riosnav/sen69c-esp32-tft-air-monitor/enclosure/main_enclosure.step

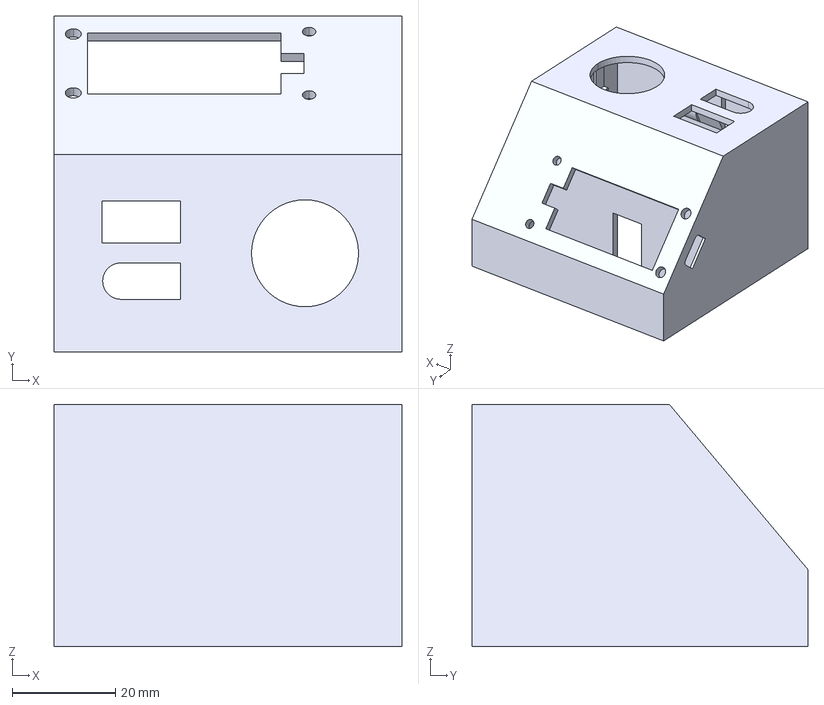
[picture p5: CAD file, 2026-11-09]
enclosure/main_enclosure.step
67.5 x 65.1 x 47.0 mm
