riosnav/sen69c-esp32-tft-air-monitor/enclosure/lid.step

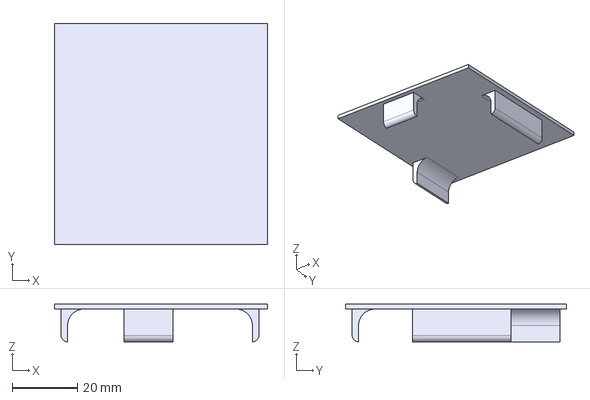
[picture p6: CAD file, 2026-11-09]
enclosure/lid.step
65.1 x 67.5 x 11.5 mm
