riosnav/sen69c-esp32-tft-air-monitor/src/Settings.cpp

// SPDX-License-Identifier: GPL-3.0-or-later

/// @file
/// @brief Loading and saving the settings and the battery's state with
/// Preferences, in the NVS namespace `settings` (see Settings.h).

#include "Settings.h"

#include <Preferences.h>

#include <algorithm>
#include <cmath>
#include <iterator>

#include "Device.h"

namespace settings {

namespace {
constexpr const char* kNamespace = "settings";  ///< The NVS namespace for all of it.
constexpr size_t kWebPasswordLength = 8;  ///< The random web password's length.
/// @brief Puts back the default of any setting outside the range the menu and
/// the web page allow, e.g. one saved by a firmware version with more choices.
/// @param[in,out] s The settings.
void keepInRange(Settings& s) {
  const Settings defaults;
  if (s.brightness < 10 || s.brightness > 100) s.brightness = defaults.brightness;
  if (std::find(std::begin(kDimOptionsS), std::end(kDimOptionsS), s.dimAfterS) ==
      std::end(kDimOptionsS)) {
    s.dimAfterS = defaults.dimAfterS;
  }
  if (static_cast<uint8_t>(s.led) > static_cast<uint8_t>(LedMode::Bright)) s.led = defaults.led;
  if (static_cast<uint8_t>(s.silence) > static_cast<uint8_t>(Silence::All)) {
    s.silence = defaults.silence;
  }
  if (!(std::fabs(s.tempOffsetC) <= 10)) s.tempOffsetC = defaults.tempOffsetC;  // NaN too
  if (s.altitudeM > 3000) s.altitudeM = defaults.altitudeM;
  if (s.mqttPort == 0) s.mqttPort = defaults.mqttPort;
}

}  // namespace

Settings load() {
  Settings s;
  Preferences p;
  bool hasPassword = false;
  if (p.begin(kNamespace, true)) {
    s.brightness = p.getUChar("bright", s.brightness);
    s.dimAfterS = p.getUShort("dim", s.dimAfterS);
    s.screenOffWhenIdle = p.getBool("idleOff", s.screenOffWhenIdle);
    s.fahrenheit = p.getBool("degF", s.fahrenheit);
    s.led = static_cast<LedMode>(p.getUChar("led", static_cast<uint8_t>(s.led)));
    s.silence = static_cast<Silence>(p.getUChar("silence", static_cast<uint8_t>(s.silence)));
    s.tempOffsetC = p.getFloat("tOffset", s.tempOffsetC);
    s.altitudeM = p.getUShort("alt", s.altitudeM);
    s.co2SelfCalibration = p.getBool("co2Asc", s.co2SelfCalibration);
    s.wifiEnabled = p.getBool("wifi", s.wifiEnabled);
    if (p.isKey("name")) p.getString("name", s.name, sizeof s.name);
    hasPassword = p.isKey("webPass");
    if (hasPassword) p.getString("webPass", s.webPassword, sizeof s.webPassword);
    s.mqttEnabled = p.getBool("mqtt", s.mqttEnabled);
    if (p.isKey("mqttHost")) p.getString("mqttHost", s.mqttHost, sizeof s.mqttHost);
    s.mqttPort = p.getUShort("mqttPort", s.mqttPort);
    if (p.isKey("mqttUser")) p.getString("mqttUser", s.mqttUser, sizeof s.mqttUser);
    if (p.isKey("mqttPass")) p.getString("mqttPass", s.mqttPassword, sizeof s.mqttPassword);
    p.end();
  }
  keepInRange(s);
  if (!hasPassword) {
    // First start, or after a factory reset.
    device::randomPassword(s.webPassword, kWebPasswordLength);
    save(s);
  }
  return s;
}

void save(const Settings& s) {
  Preferences p;
  if (!p.begin(kNamespace, false)) {
    Serial.println("Settings: could not save them");
    return;
  }
  p.putUChar("bright", s.brightness);
  p.putUShort("dim", s.dimAfterS);
  p.putBool("idleOff", s.screenOffWhenIdle);
  p.putBool("degF", s.fahrenheit);
  p.putUChar("led", static_cast<uint8_t>(s.led));
  p.putUChar("silence", static_cast<uint8_t>(s.silence));
  p.putFloat("tOffset", s.tempOffsetC);
  p.putUShort("alt", s.altitudeM);
  p.putBool("co2Asc", s.co2SelfCalibration);
  p.putBool("wifi", s.wifiEnabled);
  p.putString("name", s.name);
  p.putString("webPass", s.webPassword);
  p.putBool("mqtt", s.mqttEnabled);
  p.putString("mqttHost", s.mqttHost);
  p.putUShort("mqttPort", s.mqttPort);
  p.putString("mqttUser", s.mqttUser);
  p.putString("mqttPass", s.mqttPassword);
  p.end();
}

void erase() {
  Preferences p;
  if (!p.begin(kNamespace, false)) return;
  p.clear();
  p.end();
}

// Under the key of the setting it replaces ("A battery is connected"), so a
// monitor that had it ticked starts with a battery.
bool loadBatteryPresent() {
  Preferences p;
  if (!p.begin(kNamespace, true)) return false;
  const bool present = p.getBool("battery", false);
  p.end();
  return present;
}

void saveBatteryPresent(bool present) {
  Preferences p;
  if (!p.begin(kNamespace, false)) return;
  p.putBool("battery", present);
  p.end();
}

float loadBatteryEmpty() {
  Preferences p;
  if (!p.begin(kNamespace, true)) return NAN;
  const float percent = p.getFloat("battEmpty", NAN);
  p.end();
  return percent;
}

void saveBatteryEmpty(float percent) {
  Preferences p;
  if (!p.begin(kNamespace, false)) return;
  p.putFloat("battEmpty", percent);
  p.end();
}

}  // namespace settings
