riosnav/sen69c-esp32-tft-air-monitor/src/net/Ota.cpp

// SPDX-License-Identifier: GPL-3.0-or-later

/// @file
/// @brief Firmware updates over Wi-Fi: receiving the image, confirming it on
/// the monitor, and confirming or rolling back new firmware (see Ota.h).

#include "Ota.h"

#include <Arduino.h>
#include <esp_app_format.h>

#include <cstring>

#include "System.h"

namespace {

/// How long a new image has to rejoin Wi-Fi before it's rolled back, in ms.
constexpr uint32_t kProbationMs = 5 * 60000;
/// After a yes, time for the web page to hear it before the restart, in ms.
constexpr uint32_t kRestartDelayMs = 3000;

/// @brief Where the app description starts in an app image, in bytes.
///
/// An app image starts with the image header, the first segment's header and
/// the app description.
constexpr size_t kAppDescOffset = sizeof(esp_image_header_t) + sizeof(esp_image_segment_header_t);

}  // namespace

/// @brief Tells the Arduino core not to confirm a new image at boot;
/// Ota::loop() does.
/// @return Always true.
extern "C" bool verifyRollbackLater() { return true; }

void Ota::begin() {
  esp_ota_img_states_t state;
  probation_ = esp_ota_get_state_partition(esp_ota_get_running_partition(), &state) == ESP_OK &&
               state == ESP_OTA_IMG_PENDING_VERIFY;
  if (probation_) Serial.println("OTA: new firmware, confirms itself once it rejoins Wi-Fi");
}

void Ota::loop(bool connected, bool offline, uint32_t nowMs) {
  OtaState confirming = OtaState::Confirming;
  if (static_cast<int32_t>(nowMs - deadlineMs_) >= 0 &&
      state_.compare_exchange_strong(confirming, OtaState::TimedOut)) {
    Serial.println("OTA: not confirmed on the monitor; update discarded");
  }

  if (!probation_) return;
  if (connected || offline) {
    probation_ = false;
    esp_ota_mark_app_valid_cancel_rollback();
    Serial.println("OTA: new firmware confirmed");
  } else if (nowMs >= kProbationMs) {
    Serial.println("OTA: new firmware can't rejoin Wi-Fi; rolling back");
    Serial.flush();
    esp_ota_mark_app_invalid_rollback_and_reboot();
  }
}

const char* Ota::start(size_t size) {
  OtaState current = state_;
  do {
    if (current == OtaState::Receiving || current == OtaState::Confirming ||
        current == OtaState::Accepted) {
      return "Another update is running";
    }
  } while (!state_.compare_exchange_weak(current, OtaState::Receiving));
  written_ = 0;
  size_ = size;
  partition_ = esp_ota_get_next_update_partition(nullptr);
  if (partition_ == nullptr) return fail("No OTA partition");
  if (size < kAppDescOffset + sizeof(esp_app_desc_t) || size > partition_->size) {
    return fail("Wrong file size for a firmware image");
  }
  if (esp_ota_begin(partition_, OTA_WITH_SEQUENTIAL_WRITES, &handle_) != ESP_OK) {
    return fail("Could not start the update");
  }
  Serial.printf("OTA: receiving %u bytes\n", static_cast<unsigned>(size));
  return nullptr;
}

const char* Ota::write(const uint8_t* data, size_t length) {
  if (written_ == 0) {
    // Refuse anything that isn't an app image for this chip, such as the
    // merged "factory" image that also contains the bootloader.
    esp_image_header_t header;
    esp_app_desc_t desc;
    if (length < kAppDescOffset + sizeof desc) return fail("Not a firmware image");
    memcpy(&header, data, sizeof header);
    memcpy(&desc, data + kAppDescOffset, sizeof desc);
    if (header.magic != ESP_IMAGE_HEADER_MAGIC || desc.magic_word != ESP_APP_DESC_MAGIC_WORD) {
      return fail("Not a firmware image (use firmware.bin)");
    }
    if (header.chip_id != CONFIG_IDF_FIRMWARE_CHIP_ID) return fail("Firmware is for another chip");
  }
  if (esp_ota_write(handle_, data, length) != ESP_OK) return fail("Could not write to flash");
  written_ += length;
  return nullptr;
}

const char* Ota::finish() {
  if (written_ != size_) return fail("Upload incomplete");
  const esp_err_t err = esp_ota_end(handle_);
  handle_ = 0;
  if (err != ESP_OK) return fail("The image is damaged");
  Serial.println("OTA: update stored; waiting for confirmation on the monitor");
  deadlineMs_ = millis() + kConfirmWindowMs;
  state_ = OtaState::Confirming;
  return nullptr;
}

void Ota::abort() { fail(nullptr); }

void Ota::confirm() {
  OtaState confirming = OtaState::Confirming;
  if (!state_.compare_exchange_strong(confirming, OtaState::Accepted)) return;
  if (esp_ota_set_boot_partition(partition_) != ESP_OK) {
    Serial.println("OTA: could not select the image");
    state_ = OtaState::Failed;
    return;
  }
  Serial.println("OTA: confirmed on the monitor; restarting into it");
  sys::restartLater(kRestartDelayMs);
}

void Ota::refuse() {
  OtaState confirming = OtaState::Confirming;
  if (state_.compare_exchange_strong(confirming, OtaState::Refused)) {
    Serial.println("OTA: refused on the monitor; update discarded");
  }
}

const char* Ota::fail(const char* reason) {
  if (handle_ != 0) esp_ota_abort(handle_);
  handle_ = 0;
  if (reason != nullptr) Serial.printf("OTA: %s\n", reason);
  state_ = OtaState::Idle;
  return reason;
}

uint8_t Ota::percent() const {
  const uint32_t size = size_;  // set by the web server's task
  return size == 0 ? 0 : static_cast<uint8_t>(static_cast<uint64_t>(written_.load()) * 100 / size);
}

uint32_t Ota::secondsLeft(uint32_t nowMs) const {
  if (state_ != OtaState::Confirming) return 0;
  const int32_t left = static_cast<int32_t>(deadlineMs_ - nowMs);
  return left > 0 ? (static_cast<uint32_t>(left) + 999) / 1000 : 0;
}
