riosnav/sen69c-esp32-tft-air-monitor/src/ui/Ui.cpp

// SPDX-License-Identifier: GPL-3.0-or-later

/// @file
/// @brief The UI's input and state: buttons, the menu and its actions,
/// alerts, the backlight and the status LED (see Ui.h; the drawing is in
/// UiDraw.cpp).

#include "Ui.h"

#include <algorithm>
#include <iterator>

#include "Power.h"

namespace {

/// @brief The buttons' pins: D0, D1 and D2.
///
/// D0 doubles as BOOT and is pulled up; D1/D2 are pulled down (so they can wake
/// the chip from deep sleep), so they read HIGH when pressed.
constexpr uint8_t kButtonPins[] = {0, 1, 2};
constexpr bool kPressedLevel[] = {LOW, HIGH, HIGH};  ///< What each button reads while pressed.

constexpr uint8_t kDimmedBrightness = 4;  ///< Backlight while dimmed, of 255.
constexpr uint32_t kDrawIntervalMs = 250;  ///< How often to redraw, in ms, even if nothing changed.
constexpr uint32_t kToastMs = 4000;  ///< How long a toast shows, in ms.
constexpr uint32_t kMenuTimeoutMs = 60000;  ///< A menu left alone this long closes, in ms.
/// An alert left alone this long on screen closes, as if dismissed, in ms.
constexpr uint32_t kAlertTimeoutMs = 60000;
/// When the screen switches off while silenced, in s, if it's set never to dim.
constexpr uint32_t kSilencedIdleS = 120;
/// CO2 in fresh outdoor air, in ppm: the forced recalibration's reference.
constexpr uint16_t kOutdoorCo2Ppm = 420;

/// @brief Steps an enum through its values, wrapping around.
/// @tparam E The enum, with values from 0 to `count` - 1.
/// @param value The value to step from.
/// @param delta How far: +1 for the next value, -1 for the previous one.
/// @param count The enum's `Count`, one past its last value.
/// @return The value stepped to.
template <typename E>
E stepEnum(E value, int delta, E count) {
  const int n = static_cast<int>(count);
  return static_cast<E>((static_cast<int>(value) + delta + n) % n);
}

/// @brief A brightness setting as the backlight takes it.
/// @param percent The brightness, in %.
/// @return The backlight, of 255.
uint8_t backlight(uint8_t percent) { return static_cast<uint8_t>(percent * 255 / 100); }

/// @brief Whether an alert at `level` may turn the screen on.
///
/// A very low battery counts as an alarm, since the monitor will soon switch
/// itself off; a low one as a warning.
/// @param silence The Silence setting.
/// @param level The alert's level.
bool wakesScreen(Silence silence, aq::Level level) {
  return silence == Silence::Off || (silence == Silence::Warnings && level == aq::Level::Alarm);
}

/// @brief Whether an update fills the screen: it's arriving, waiting for an
/// answer, or installing.
/// @param state The update's state.
bool updating(OtaState state) {
  return state == OtaState::Receiving || state == OtaState::Confirming ||
         state == OtaState::Accepted;
}

}  // namespace

void Ui::begin(SensorService& sensor, Settings& settings, const aq::AirQuality& airQuality,
               const aq::MetricHistory& history, WifiService& wifi, Ota& ota,
               const MqttService& mqtt, const power::BatteryWatch& battery) {
  sensor_ = &sensor;
  settings_ = &settings;
  aq_ = &airQuality;
  history_ = &history;
  wifi_ = &wifi;
  ota_ = &ota;
  mqtt_ = &mqtt;
  battery_ = &battery;

  for (size_t i = 0; i < 3; ++i) {
    pinMode(kButtonPins[i], kPressedLevel[i] == LOW ? INPUT_PULLUP : INPUT_PULLDOWN);
    // E.g. D1 still held from switching on: not a long press for the menu.
    if (digitalRead(kButtonPins[i]) == kPressedLevel[i]) buttons_[i].ignoreHeld();
  }
  tft_.init();
  tft_.setRotation(1);  // landscape, buttons on the left (D0 top, D2 bottom)
  tft_.setBrightness(backlight(settings.brightness));
  frame_.setColorDepth(16);
  if (!frame_.createSprite(tft_.width(), tft_.height())) Serial.println("UI: no memory for frame");
  lastInputMs_ = millis();
}

void Ui::update(const SensorSnapshot& snapshot, uint32_t nowMs) {
  snapshot_ = snapshot;
  if (settingsChanged_) {
    settingsChanged_ = false;
    applyBacklight();
    commitSettings();
    dirty_ = true;
  }
  if (snapshot.resultSequence != resultSequence_) {
    resultSequence_ = snapshot.resultSequence;
    showToast(snapshot.result, nowMs);
  }
  if (toast_[0] != '\0' && static_cast<int32_t>(nowMs - toastUntilMs_) >= 0) {
    toast_[0] = '\0';  // its time is up
    dirty_ = true;
  }
  updateAlerts(nowMs);
  updatePrompt(nowMs);
  for (size_t i = 0; i < 3; ++i) {
    const bool down = digitalRead(kButtonPins[i]) == kPressedLevel[i];
    handleButton(i, buttons_[i].update(down, nowMs), nowMs);
  }
  // Left alone, menus close by themselves, saving a value being changed.
  if (mode_ != Mode::Pages && nowMs - lastInputMs_ >= kMenuTimeoutMs) {
    if (mode_ == Mode::Edit) commitSettings();
    mode_ = Mode::Pages;
    dirty_ = true;
  }
  updateBacklight(nowMs);
  // Silenced, the LED stays dark, except for an alarm that may turn the screen on.
  const bool alarm = alertVisible_ && alertLevel_ == aq::Level::Alarm;
  const bool ledOn =
      settings_->silence == Silence::Off || (alarm && wakesScreen(settings_->silence, alertLevel_));
  led_.update(aq_->overall(), warmingUp(), alarm, ledOn ? settings_->led : LedMode::Off, nowMs);
  if (dirty_ || nowMs - lastDrawMs_ >= kDrawIntervalMs) {
    draw(nowMs);
    lastDrawMs_ = nowMs;
    dirty_ = false;
  }
}

void Ui::showBatteryEmpty() {
  batteryEmpty_ = true;
  dimmed_ = false;
  applyBacklight();
  draw(millis());
}

void Ui::showPoweringOff(uint32_t secondsLeft) {
  offInS_ = secondsLeft;
  draw(millis());
}

void Ui::handleButton(size_t button, aq::ButtonEvent event, uint32_t nowMs) {
  using aq::ButtonEvent;
  if (event == ButtonEvent::None) return;
  lastInputMs_ = nowMs;
  if (ota_->state() == OtaState::Confirming) {
    onUpdatePromptEvent(button, event, nowMs);
    return;
  }
  if (event == ButtonEvent::Press) {
    // A press that wakes the screen does nothing else.
    if (dimmed_) {
      buttons_[button].swallow();
      updateBacklight(nowMs);
    }
    return;
  }
  dirty_ = true;
  if (updating(ota_->state())) return;  // nothing to do but wait
  if (wifi_->setupActive()) {
    // D1 cancels the setup, or closes it once it has worked.
    if (button == 1 && event == ButtonEvent::Click) wifi_->stopSetup();
    return;
  }
  if (alertShowing()) {
    if (event == ButtonEvent::Click) dismissAlert();
    return;
  }
  switch (mode_) {
    case Mode::Pages:
      onPageEvent(button, event);
      break;
    case Mode::Menu:
      onMenuEvent(button, event);
      break;
    case Mode::Edit:
      onEditEvent(button, event);
      break;
    case Mode::Confirm:
      onConfirmEvent(button, event);
      break;
    case Mode::Link:
      if (event == ButtonEvent::Click) mode_ = Mode::Pages;
      break;
  }
}

void Ui::onPageEvent(size_t button, aq::ButtonEvent event) {
  using aq::ButtonEvent;
  if (button == 1 && event == ButtonEvent::LongPress) {
    mode_ = Mode::Menu;
    item_ = Item::Brightness;
    menuTop_ = 0;
    return;
  }
  if (event != ButtonEvent::Click) return;
  if (button == 0) {
    page_ = stepEnum(page_, -1, Page::Count);
  } else if (button == 2) {
    page_ = stepEnum(page_, +1, Page::Count);
  } else if (page_ == Page::TrendHour || page_ == Page::TrendDay || page_ == Page::TrendWeek) {
    trendMetric_ = (trendMetric_ + 1) % kTrendMetrics.size();
  } else if (page_ == Page::Network) {
    onNetworkAction();
  } else if (page_ == Page::Device && snapshot_.deviceStatus != 0) {
    sensor_->clearErrors();
  }
}

void Ui::onNetworkAction() {
  if (!settings_->wifiEnabled && wifi_->saved().size() > 0) {
    settings_->wifiEnabled = true;
    commitSettings();
  } else if (wifi_->state() == WifiState::Connected) {
    mode_ = Mode::Link;  // QR code of the web page
  } else {
    wifi_->startSetup();
  }
}

void Ui::onMenuEvent(size_t button, aq::ButtonEvent event) {
  using aq::ButtonEvent;
  if (button == 1) {
    if (event == ButtonEvent::Click) {
      select(item_);
    } else if (event == ButtonEvent::LongPress) {
      mode_ = Mode::Pages;
    }
    return;
  }
  // Clicks move one row; holding keeps scrolling.
  item_ = stepEnum(item_, button == 0 ? -1 : +1, Item::Count);
}

void Ui::onEditEvent(size_t button, aq::ButtonEvent event) {
  using aq::ButtonEvent;
  if (button == 1) {
    if (event == ButtonEvent::Click) {
      mode_ = Mode::Menu;
      commitSettings();
    }
    return;
  }
  editRepeats_ = event == ButtonEvent::Click ? 0 : editRepeats_ + 1;
  adjust(item_, button == 0 ? +1 : -1);
}

void Ui::onConfirmEvent(size_t button, aq::ButtonEvent event) {
  using aq::ButtonEvent;
  if (button == 1 && event == ButtonEvent::LongPress) {
    mode_ = Mode::Pages;
    execute(confirmItem_);
  } else if (button != 1 && event == ButtonEvent::Click) {
    mode_ = Mode::Menu;
  }
}

void Ui::onUpdatePromptEvent(size_t button, aq::ButtonEvent event, uint32_t nowMs) {
  if (event == aq::ButtonEvent::Press && !holding_) {
    holding_ = true;
    holdButton_ = button;
    holdStartMs_ = nowMs;
  } else if (event == aq::ButtonEvent::Click) {
    ota_->refuse();
  }
  dirty_ = true;
}

void Ui::updatePrompt(uint32_t nowMs) {
  const OtaState state = ota_->state();
  if (state != otaState_) {
    otaState_ = state;
    holding_ = false;
    dirty_ = true;
    switch (state) {
      case OtaState::Confirming:
        lastInputMs_ = nowMs;  // wake the screen
        break;
      case OtaState::Refused:
        showToast("Update refused", nowMs);
        break;
      case OtaState::TimedOut:
        showToast("Update not confirmed", nowMs);
        break;
      case OtaState::Failed:
        showToast("Update could not be installed", nowMs);
        break;
      default:
        break;
    }
  }
  if (state != OtaState::Confirming || !holding_) return;
  if (!buttons_[holdButton_].pressed()) {
    ota_->refuse();  // let go too soon
  } else if (nowMs - holdStartMs_ >= Ota::kConfirmHoldMs) {
    ota_->confirm();
  }
}

void Ui::select(Item item) {
  switch (item) {
    case Item::Brightness:
    case Item::TempOffset:
    case Item::Altitude:
      mode_ = Mode::Edit;
      editRepeats_ = 0;
      break;
    case Item::DimAfter:
    case Item::IdleScreen:
    case Item::Units:
    case Item::Led:
    case Item::Silence:
    case Item::Wifi:
    case Item::Co2SelfCalibration:
      adjust(item, +1);
      commitSettings();
      break;
    case Item::WifiSetup:
      mode_ = Mode::Pages;
      page_ = Page::Network;  // where the result shows once the setup ends
      wifi_->startSetup();
      break;
    case Item::CleanFan:
    case Item::HeatHumiditySensor:
    case Item::RestartVoc:
    case Item::CalibrateCo2:
    case Item::ResetCo2:
    case Item::ForgetWifi:
    case Item::Restart:
    case Item::PowerOff:
    case Item::FactoryReset:
      confirmItem_ = item;
      mode_ = Mode::Confirm;
      break;
    case Item::Close:
    case Item::Count:
      mode_ = Mode::Pages;
      break;
  }
}

void Ui::adjust(Item item, int direction) {
  Settings& s = *settings_;
  switch (item) {
    case Item::Brightness:
      s.brightness = static_cast<uint8_t>(std::clamp(s.brightness + direction * 10, 10, 100));
      tft_.setBrightness(backlight(s.brightness));
      break;
    case Item::DimAfter: {
      const size_t n = std::size(kDimOptionsS);
      size_t i = 0;
      while (i < n && kDimOptionsS[i] != s.dimAfterS) ++i;
      s.dimAfterS = kDimOptionsS[(i + n + direction) % n];
      break;
    }
    case Item::IdleScreen:
      s.screenOffWhenIdle = !s.screenOffWhenIdle;
      break;
    case Item::Units:
      s.fahrenheit = !s.fahrenheit;
      break;
    case Item::Led:
      s.led = static_cast<LedMode>((static_cast<int>(s.led) + direction + 3) % 3);
      break;
    case Item::Silence:
      s.silence = static_cast<Silence>((static_cast<int>(s.silence) + direction + 3) % 3);
      break;
    case Item::Wifi:
      s.wifiEnabled = !s.wifiEnabled;
      break;
    case Item::TempOffset:
      s.tempOffsetC = std::clamp(std::round(s.tempOffsetC * 10 + direction) / 10, -10.0f, 10.0f);
      break;
    case Item::Altitude: {
      // Holding the button speeds up after a second or two.
      const int step = editRepeats_ > 10 ? 100 : 10;
      s.altitudeM = static_cast<uint16_t>(
          std::clamp((s.altitudeM + direction * step) / step * step, 0, 3000));
      break;
    }
    case Item::Co2SelfCalibration:
      s.co2SelfCalibration = !s.co2SelfCalibration;
      break;
    default:
      break;
  }
}

void Ui::execute(Item item) {
  switch (item) {
    case Item::CleanFan:
      sensor_->cleanFan();
      break;
    case Item::HeatHumiditySensor:
      sensor_->heatHumiditySensor();
      break;
    case Item::RestartVoc:
      sensor_->restartVocLearning();
      break;
    case Item::CalibrateCo2:
      sensor_->recalibrateCo2(kOutdoorCo2Ppm);
      break;
    case Item::ResetCo2:
      sensor_->resetCo2Calibration();
      break;
    case Item::ForgetWifi:
      wifi_->forgetAll();
      showToast("Wi-Fi networks forgotten", millis());
      break;
    case Item::Restart:
      ESP.restart();
      break;
    case Item::PowerOff:
      poweringOff_ = true;  // the main loop counts down and switches off
      offInS_ = power::kOffCountdownS;
      break;
    case Item::FactoryReset:
      settings::erase();
      wifi_->forgetAll();
      ESP.restart();
      break;
    default:
      break;
  }
}

void Ui::commitSettings() {
  settings::save(*settings_);
  sensor_->applyConfig(
      {settings_->tempOffsetC, settings_->altitudeM, settings_->co2SelfCalibration});
}

void Ui::updateAlerts(uint32_t nowMs) {
  // Show the worst metric that is at warning or alarm and hasn't been
  // acknowledged at that level. Once a metric improves its acknowledgement is
  // lowered too, so it alerts again if it gets worse. A value that's briefly
  // unknown, e.g. while the sensor restarts, hasn't improved.
  bool found = false;
  aq::Metric metric = aq::Metric::Co2;
  aq::Level level = aq::Level::Good;
  for (aq::Metric m : aq::kPriority) {
    aq::Level& acknowledged = acknowledged_[aq::idx(m)];
    const aq::Level current = aq_->level(m);
    if (current != aq::Level::Unknown && current < acknowledged) acknowledged = current;
    if (aq_->thresholds(m).any() && current >= aq::Level::Warning && current > acknowledged &&
        current > level) {
      found = true;
      metric = m;
      level = current;
    }
  }
  bool isNew = found && (!alertVisible_ || metric != alertMetric_ || level != alertLevel_);
  alertVisible_ = found;
  alertMetric_ = metric;
  alertLevel_ = level;

  // The battery, while it runs the monitor: low, then very low. It waits
  // behind an air alert.
  const uint8_t battery = battery_->warning();
  if (battery < batteryAcknowledged_) batteryAcknowledged_ = battery;
  const uint8_t batteryAlert = battery > batteryAcknowledged_ ? battery : 0;
  if (batteryAlert != batteryAlert_ && batteryAlert != 0 && !alertVisible_) isNew = true;
  batteryAlert_ = batteryAlert;

  if (isNew) {
    alertShownMs_ = nowMs;
    // Silenced, it waits for a button press to turn the screen on.
    const aq::Level shown = alertVisible_         ? alertLevel_
                            : batteryAlert_ == 2 ? aq::Level::Alarm
                                                 : aq::Level::Warning;
    if (wakesScreen(settings_->silence, shown)) lastInputMs_ = nowMs;  // wake the screen
    dirty_ = true;
  }
  // Left alone, an alert closes by itself, as if dismissed, a minute after
  // it could be seen: the screen on, and not filled by something else.
  if (alertShowing() && (dimmed_ || fullScreen())) alertShownMs_ = nowMs;
  if (alertShowing() && nowMs - alertShownMs_ >= kAlertTimeoutMs) dismissAlert();
}

void Ui::dismissAlert() {
  if (alertVisible_) {
    acknowledged_[aq::idx(alertMetric_)] = alertLevel_;
    alertVisible_ = false;
  } else {
    batteryAcknowledged_ = batteryAlert_;
    batteryAlert_ = 0;
  }
  alertShownMs_ = millis();  // the timeout starts again for an alert waiting behind
  dirty_ = true;
}

void Ui::updateBacklight(uint32_t nowMs) {
  // Screens that show something to scan or wait for stay bright, and so does
  // an alert once the screen is on.
  const bool alertOnScreen = alertShowing() && !dimmed_;
  const uint32_t idleS = idleAfterS();
  const bool dim = idleS != 0 && mode_ == Mode::Pages && !fullScreen() && !alertOnScreen &&
                   nowMs - lastInputMs_ >= idleS * 1000UL;
  // Idle, the time since the last input stops growing, so millis() wrapping
  // after 49.7 days doesn't make it look recent.
  if (dim) lastInputMs_ = nowMs - idleS * 1000UL;
  if (dim == dimmed_) return;
  dimmed_ = dim;
  applyBacklight();
}

bool Ui::fullScreen() const { return wifi_->setupActive() || updating(ota_->state()); }

uint32_t Ui::idleAfterS() const {
  const bool never = settings_->dimAfterS == 0;
  return never && settings_->silence != Silence::Off ? kSilencedIdleS : settings_->dimAfterS;
}

void Ui::applyBacklight() {
  const bool off = dimmed_ && (settings_->screenOffWhenIdle || settings_->silence != Silence::Off);
  if (off != screenOff_) {
    screenOff_ = off;
    if (off) {
      tft_.sleep();
    } else {
      tft_.wakeup();
    }
  }
  if (!off) tft_.setBrightness(dimmed_ ? kDimmedBrightness : backlight(settings_->brightness));
}

void Ui::showToast(const char* text, uint32_t nowMs) {
  strlcpy(toast_, text, sizeof toast_);
  toastUntilMs_ = nowMs + kToastMs;
  dirty_ = true;
}

bool Ui::warmingUp() const {
  if (snapshot_.state != SensorState::Measuring) return true;
  for (float v : snapshot_.measurement.values) {
    if (std::isnan(v)) return true;
  }
  return false;
}
