riosnav/sen69c-esp32-tft-air-monitor/tools/screen-renderer/shim/DNSServer.h

// SPDX-License-Identifier: GPL-3.0-or-later

/// @file
/// @brief Stand-in for Arduino-ESP32's DNSServer.h (a WifiService member).
#pragma once

/// Stand-in for Arduino-ESP32's DNS server: empty, as only WifiService's
/// declaration needs it.
class DNSServer {};
