riosnav/sen69c-esp32-tft-air-monitor/(commit log)

2026-10-29 M0: hardware bring-up
    - pioarduino build pinned to Arduino-ESP32 3.3.11 (ESP-IDF 5.5.5),
    two 1.875 MB OTA partitions, build output kept out of the repo
    - LovyanGFX config for the 240x135 ST7789 panel (rotation and offset
    verified on hardware)
    - I2C scan, SEN69C readout over USB serial and on screen, button and
    NeoPixel checks
    - GPL-3.0-or-later license, README, third-party notices
2026-10-29 M1: standalone air-quality monitor
    - Sensor task owns the I2C bus: resumes or starts measuring, re-applies
    volatile sensor settings, blanks PM for the first 30 s, polls status and
    battery, and runs fan cleaning and forced CO2 recalibration on request.
    - aqcore library: warning/alarm levels with hysteresis, 1 h and 24 h
    history, button debouncing with long press and repeat, comfort maths,
    with Unity tests that run on the board.
    - UI with seven pages (overview, particles, gases, comfort, two trend
    charts, device), a settings menu, pop-up alerts with acknowledgement,
    auto-dim and a NeoPixel status LED.
    - Settings stored in NVS.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
2026-10-30 Web chart clock times and readout, value info, battery option
    - Web chart: clock times on the time axis; hovering or touching shows
    the time and value under the pointer.
    - (i) on every value: what it is, the health risk, its limits and their
    sources (CO2 now cites Health Canada, the German UBA and UK BB101).
    - "Jump here when a value is clicked" switch, remembered per browser.
    - Battery readings are only shown when a battery is set as connected;
    without one the gauge reads the charger (off by default).
    - The sensor reports its altitude back when it's set, and the web page
    shows it. Kept in RTC memory, so it stays valid across restarts that
    leave the sensor measuring.
    - Menus close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
2026-10-30 Show the sensor's tolerance on the web page
    Values and the chart readout show the typical tolerance from Sensirion's
    SEN6x datasheet (SEN69C), and the chart shades it as a band around the
    line. The info box gives the formula and when it applies. A checkbox
    turns it off, remembered by the browser. The VOC and NOx indices have no
    band, as every sensor reads 100 and 1 in a room's usual air.
2026-10-30 Fixes from the M2 hardware tests
    - Wi-Fi page: when a saved network is in range but can't be joined, say
    so and why ("Couldn't join WIFI / Wrong password?") instead of "No saved
    network in range".
    - Count WIFI_REASON_AUTH_EXPIRE as a wrong password: the router sends it
    when it rejects the key during setup, which was reported as "No answer"
    after the 20 s timeout.
    - After a restart, keep the sensor measuring only if it has our altitude
    and CO2 self-calibration setting. After a factory reset it kept the old
    altitude while the settings said 0 m; now it's reconfigured.
    [SensorService.cpp, UiDraw.cpp, WifiService.cpp, WifiService.h]
2026-10-30 Group the settings menu: display, Wi-Fi, sensor, device
    Forget Wi-Fi now follows Wi-Fi and Set up Wi-Fi, and the CO2 calibration
    follows CO2 self-calibration.
2026-10-30 M3: Home Assistant over MQTT (v0.3.0)
    The monitor publishes to an MQTT broker, such as Home Assistant's Mosquitto
    add-on, using ESP-IDF's MQTT client:
    - MQTT device discovery announces one device with a sensor per value, a
    Good/Fair/Poor status sensor per value with limits, the overall air
    quality and the Wi-Fi signal. Units are spelled as Home Assistant
    expects (Greek mu), so it keeps long-term statistics.
    - Readings every 30 s as JSON on <host>/state; <host>/status is
    online/offline, with a last will so Home Assistant shows the sensors
    as unavailable when the monitor loses power.
    - Broker, port, user and password on the web page (POST /api/mqtt),
    saved with the other settings.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
    [Json.h, MqttService.cpp, MqttService.h, Settings.cpp, Settings.h, Ui.cpp, Ui.h, UiDraw.cpp]
2026-10-30 Close alert pop-ups by themselves after a minute
    Left alone, an alert now counts as dismissed after 60 s, as the menus
    close by themselves, instead of waiting for a button. The value only
    alerts again if it gets worse.
2026-10-30 README: rewrite for builders new to the project
    Reorganised in the order a newcomer needs it: what you need (with product
    numbers, what's included, cables, power, optional battery), assembly,
    installing the firmware step by step (getting the code, VS Code and the
    pioarduino extension, the first 3-4 GB download, what success looks
    like), first start, using it (levels, accuracy, settings), Wi-Fi and
    the web page, Home Assistant, updating, troubleshooting, and a separate
    section for developers.
    Also corrects: the board ships with Adafruit's demo (not CircuitPython),
    Home Assistant 2026.2 calls add-ons apps, the setup hotspot's timeouts,
    the size of the tools and build output, and that pio isn'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
2026-10-30 Screen: messages over the title bar, no space before one-digit numbers
    - Messages such as "Fan cleaned" cover the title bar instead of the
    bottom strip. There they cut through the last row on the overview,
    particles and gases pages, with the tops of the digits showing above
    the bar; the title bar is in the same place on every screen.
    - Whole numbers with one digit are drawn without a leading space:
    Arduino's String(value, 0) pads to two characters, so NOx showed as
    " 1". Also fixes the trend graphs' limits and the battery percentage.
    - Removes a duplicate comment.
    Found with a desktop renderer of the screen.
    [UiDraw.cpp]
2026-10-30 Sensor: VOC and NOx of 0 count as not measured yet
    The indices run from 1 to 500, but for about the first minute of a
    measurement (after power-up, fan cleaning, or a settings change that
    restarts the sensor) the SEN69C reports 0 rather than unknown. That
    showed as "VOC 0" and "NOx 0", rated good, and went to Home Assistant
    and the trend graphs as real readings. They now show "--" until the
    sensor has values.
2026-10-30 README: screenshots of the screen, the web page and Home Assistant
    One each: the main screen (from a desktop renderer of the firmware's UI
    code), the top of the web page (served with made-up readings and generic
    names), and the monitor's device page in Home Assistant.
2026-10-30 README: no-warranty disclaimer
    A plain-language disclaimer (as is, at your own risk, no liability, not a
    safety or certified measuring device), and the GPL's standard no-warranty
    paragraph in the License section.
2026-10-30 Name the project sen69c-esp32-tft-air-monitor
    The repository's name on GitHub, in the README's download and update
    steps, and as the origin of the Home Assistant discovery message, which
    now also links to the project.
2026-10-31 Screen: say "Busy" when the sensor's activity doesn't fit
    While the sensor is busy, the title bar shows what it's doing, e.g.
    "Cleaning fan", at the right. Beside a long page title that text ran into
    the title; when it doesn't fit, it now says "Busy". The Device page still
    shows the whole text.
    [UiDraw.cpp]
2026-10-31 README and web page: the sensor doesn't clean its fan by itself
    Both said the sensor also cleans its fan weekly on its own, which the
    SEN69C doesn't do; that's what Clean fan is for.
2026-10-31 README: name the board and the sensor in the first paragraph
    The Adafruit ESP32-S3 Reverse TFT Feather and the Sensirion SEN69C, on
    Adafruit's SEN6x breakout board.
2026-10-31 Heat the humidity sensor, from the menu or the web page
    After a long time in very humid air, the SEN69C's humidity sensor reads
    too high; a second of its built-in heater fixes that. The heater may only
    run while the sensor is idle, so measuring stops, the heater runs (sensor
    firmware 9.0 and later report when it's done), and measuring starts again
    after the 20 s the datasheet asks for. Readings pause for about a minute.
    New: Settings > Heat humidity sensor, with a confirmation, and a task
    under Maintenance on the web page (action heatHumiditySensor).
    [SensorService.cpp, SensorService.h, Ui.cpp, Ui.h, UiDraw.cpp, Web.cpp, Web.h]
2026-10-31 Reset the CO2 calibration, from the menu or the web page
    Erases every CO2 calibration, forced or automatic (CO2 Sensor Factory
    Reset), e.g. to undo a calibration made indoors by mistake. The automatic
    self-calibration then starts over.
    New: Settings > Reset CO2 calibration, with a confirmation, and a task
    under Maintenance on the web page (action resetCo2Calibration).
    [SensorService.cpp, SensorService.h, Ui.cpp, Ui.h, UiDraw.cpp, Web.cpp, Web.h]
2026-10-31 Clear the sensor's errors, from the Device page or the web page
    The SEN69C keeps most error flags set until they're read and cleared,
    even once the error is gone. D1 on the Device page now clears them while
    one is shown (Read And Clear Device Status), and so does a task on the
    web page that only appears while there is an error (action clearErrors).
    An error that comes back is still there.
    The web page also names the errors (fan, CO2, ...) instead of showing
    the status in hex.
    [SensorService.cpp, SensorService.h, Ui.cpp, UiDraw.cpp, Web.cpp, Web.h]
2026-10-31 Wi-Fi: a fixed IP address per saved network
    DHCP stays the default. On the web page, the new IP address button next
    to a saved network sets an address, subnet mask, gateway and optional DNS
    server for it; other networks keep using DHCP. The values are checked in
    lib/netcore (Ipv4, with unit tests) and stored with the network only when
    set, so saved networks need no migration. Changing the address of the
    network in use rejoins it at once. The monitor's Wi-Fi page marks a fixed
    address.
    [UiDraw.cpp, Web.cpp, Web.h, WifiService.cpp, WifiService.h, WifiStore.cpp, WifiStore.h]
2026-10-31 Web page: wait after wrong passwords
    After 3 wrong passwords in a row, every password is refused for a minute,
    then twice as long after each further miss, up to 15 minutes (HTTP 429
    with Retry-After). Guessing becomes slow, but the owner is never locked
    out for long. A request without a password doesn't count as a guess.
    The Device page, on the monitor and on the web page, shows how many
    wrong passwords there have been since the monitor started. The logic is
    in lib/netcore (LoginGuard), with unit tests.
    [UiDraw.cpp, Web.cpp, Web.h]
2026-10-31 Firmware updates: install only once confirmed on the monitor
    An uploaded image is stored, then the monitor asks whether to install
    it: holding any of its buttons for 5 s installs it; a short press, or 2
    minutes without an answer, discards it. So a stolen web password alone
    isn't enough to replace the firmware.
    POST /api/ota now answers 202, and the web page follows the new GET
    /api/ota to say whether the update was accepted, refused or timed out.
    [Ota.cpp, Ota.h, Ui.cpp, Ui.h, UiDraw.cpp, Web.cpp, Web.h]
2026-10-31 Battery: charge state and low-battery warnings
    The battery gauge's charge rate (MAX17048 CRATE) tells whether the
    battery is charging or running the monitor; the gauge's hibernation is
    turned off so the rate stays current. The logic is in the new
    lib/powercore (BatteryWatch), with unit tests.
    With "A battery is connected" ticked:
    - the Device page shows the charge and whether it's charging or in use;
    - while the battery runs the monitor, a pop-up warns at 20 % and again
    at 10 %, and the web page shows a banner;
    - Home Assistant gets a Battery sensor, removed again when the setting
    is turned off.
2026-10-31 Battery: switch off cleanly before it's empty
    Below about 3.5 V the board can't give the sensor the 3.15 V it needs.
    After a minute there while discharging, the monitor says so on the
    screen, tells Home Assistant it's going offline, and goes into deep sleep
    with the backlight, the STEMMA QT port (so the sensor) and the NeoPixel
    switched off.
    It wakes every 5 minutes, and on D1 or D2, and starts again once the
    battery is charging or above 3.8 V; a button pressed before then shows
    why it doesn't start.
    [MqttService.cpp, MqttService.h, Power.cpp, Power.h, Screens.h, Ui.cpp, Ui.h, UiDraw.cpp]
2026-10-31 Settings: power off
    To carry the monitor around on its battery: the same deep sleep as for an
    empty battery, but without waking on a timer, so it draws about 0.1 mA.
    Holding D1 or D2 for 2 s turns it on again; a brief press, e.g. in a bag,
    lets it sleep on, and USB power alone doesn't start it. Before sleeping,
    the battery gauge may hibernate again and the sensor task stops using the
    bus.
    [Power.cpp, Power.h, SensorService.cpp, SensorService.h, Ui.cpp, Ui.h, UiDraw.cpp, main.cpp]
2026-10-31 Screen renderer in tools/screen-renderer, for Linux and Windows
    It draws the monitor's screens to PNG files from the firmware's own UI
    code (Ui.cpp, UiDraw.cpp, Text.cpp, aqcore and powercore) with
    LovyanGFX: to see every screen without the hardware, and to check UI
    changes. The README's screenshot comes from it. Until now it lived
    outside this repository.
    It builds with CMake on Linux (GCC, build.sh) and on Windows (MSVC,
    build.ps1), with identical images, and downloads LovyanGFX 1.2.33 itself.
    scripts/gallery.txt renders every screen, including the new ones in
    1.1.0.
2026-10-31 README: mention the battery tests
    The tests paragraph listed what aqcore and netcore test, but not
    lib/powercore: the battery warnings and when to switch off.
2026-11-01 Levels: follow Spain's indoor air standard UNE 171330:2024
    Fair is the standard's "acceptable" value for IDA 2 (offices and
    classrooms, the closest category to a home) and Poor its maximum: a
    building passes when most readings are below the first and none is
    above the second. Its values are meant for single readings, like the
    monitor's, while the WHO and EU values are mostly 24-hour averages.
    - CO2: 950 / 2500 ppm (was 1000 / 1500). The standard counts 500 ppm
    above outdoor air, taken as 450 ppm.
    - PM2.5: 15 / 50 ug/m3 (was 15 / 35).
    - Temperature: Poor below 17 C (was 16), the standard's limit.
    The other limits keep their values, with European sources where the
    standard has none: the EU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
2026-11-01 Web: say why the monitor last started
    /api/state has a new "resetReason" (power-on, restart, crash, watchdog,
    brownout, wake, usb or other), and the web page's Device section shows
    it as "Last start". Until now the reason was only printed over USB at
    start-up, so a restart seen in the uptime couldn't be told apart from
    an unplug afterwards.
    [Web.cpp]
2026-11-01 History: keep 7 days of 1-minute means
    The 1-minute history grows from 24 hours to 7 days: about 400 KB more,
    still in PSRAM, which has about 1.6 MB left. It is still kept in memory
    only, so it starts over after a restart.
    - Screen: a new trend page for the last 7 days, after the 24-hour one.
    Each pixel column averages about 50 minutes. The trend titles
    shorten "Temperature" to "Temp.", which ran into the Wi-Fi icon.
    - Web: a "7 days" button on the chart. /api/history?range=week sends
    5-minute means (2016 values), enough for a chart; the day range
    still sends the 1-minute means.
    - aq::groupMeans() averages the newest samples of a ring in groups,
    with a unit test.
    - The screen rend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
    [Simulator.cpp, Ui.cpp, Ui.h, UiDraw.cpp, Web.cpp, Web.h, World.h, main.cpp]
2026-11-01 Web: download the 7-day history as a CSV file
    A "Download all values (CSV)" button under the chart saves every value's
    1-minute means for the last 7 days, a row per minute, with the local
    time of each minute.
    The monitor has no clock, so /api/history.csv gives how many seconds ago
    each minute started, and the page turns that into times with the
    browser's clock. Temperature follows the °C/°F setting. The firmware
    copies the history into PSRAM under the lock (about 400 KB, freed
    afterwards) and sends it without holding the lock.
2026-11-01 Sensor: restart VOC learning without unplugging
    A new "Restart VOC learning" item in the menu (with a confirm screen)
    and in the web page's maintenance section, action restartVocLearning.
    The VOC and NOx indices compare the air with what they learned over
    the last hours; after moving the monitor to a room with different air,
    starting afresh helps. The datasheet's only ways to restart the VOC
    algorithm are a power cycle or a Device Reset (0xD304), which has the
    same effect. So the sensor task stops measuring, resets the sensor,
    and starts again, setting the altitude, CO2 self-calibration and
    temperature offset the sensor forgot. CO2 calibrations are kept, as
    across an unplug.
    Co-Authored-By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
    [Fakes.cpp, SensorService.cpp, SensorService.h, Simulator.cpp, Ui.cpp, Ui.h, UiDraw.cpp, Web.cpp]
2026-11-01 Display: option to switch the screen off when idle
    A new setting, "Idle screen" (menu) or "Then: dim it / switch it off"
    (web page, idleScreen in /api/settings), chooses what happens after the
    "Dim after" time. It defaults to dimming, as before.
    Switched off, the backlight goes to 0 and the display chip sleeps; the
    power pin the screen shares with the sensor's connector stays on, so
    the sensor, history, web page and Home Assistant carry on. A button
    press or an alert wakes it, like a dimmed screen.
2026-11-01 Sensor: measure at least 60 s before stopping
    The VOC and NOx algorithms only take their starting point after about
    45 s of measuring (until then they report 0, shown as "--"). Stopped
    earlier, they take it from the unsettled readings after the restart.
    Found on the device: heating the humidity sensor 30 s after "Restart
    VOC learning" left NOx near 500 and VOC at 1. The same restart alone,
    and the heater 5 minutes later, were both fine.
    Every operation that stops the sensor (fan cleaning, heater, CO2
    actions, settings changes) now waits until it has measured for 60 s,
    instead of the 24 s CO2 conditioning needs. Normally nothing changes;
    right after a start the operation just begins a little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
2026-11-01 Display: say "Receiving update" until an update is confirmed
    The screen said "Updating firmware" while an update was only being
    uploaded: it is stored beside the running firmware and installed only
    once someone holds a button on the monitor. It now says "Receiving
    update" and "Asks before installing", and "Installing update" once
    confirmed.
2026-11-01 Power: start right after the 2 s hold; count down before switching off
    Turning the monitor on waited until D1 or D2 was released after the
    2 s hold, which was confusing, and didn't help against a button held
    in a bag either: the wait gave up after 10 s. It now starts as soon as
    the hold is long enough. The UI ignores a button that is already down
    when it starts (ButtonLogic::ignoreHeld, with a unit test), so the held
    D1 doesn't open the settings, and the 2 s wait for a serial monitor is
    skipped after waking.
    Switching off showed how to turn it on again for only about 3 s. The
    screen now counts down from 10 s ("Off in 10 s") before switching off.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
    [Power.cpp, Power.h, Ui.cpp, Ui.h, UiDraw.cpp, main.cpp]
2026-11-01 Wi-Fi: answer the web page before a new address takes effect
    Saving a fixed address (or going back to the router's) for the network
    in use rejoined inside the web request, so the page never got its
    answer and just stopped working. And the first attempt to join again
    timed out: the monitor took about 35 s to count itself connected.
    - The monitor answers first and rejoins 1 s later, and waits up to 1 s
    for the old connection to go before joining (it was 100 ms). It now
    rejoins in about 1 s.
    - The page follows the monitor to its new address. Going back to the
    router's address, the new one isn't known yet: the page tries the
    address the router gave it before (now in /api/wifi as routerI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
    [Web.cpp, WifiService.cpp, WifiService.h]
2026-11-01 MQTT: try the broker again after 3 s
    The MQTT client waited its default 10 s before reconnecting after losing
    the broker, e.g. when Wi-Fi rejoined after an address change, so Home
    Assistant got the monitor back about 15 s later. With 3 s it was back
    3.4 s after Wi-Fi.
    [MqttService.cpp]
2026-11-03 Power: keep D1 and D2 pulled down while asleep
    Asleep, the chip watches the wake buttons through its RTC side, whose
    pull-down resistors are separate from the ones pinMode() sets. They
    were never switched on, so D1 and D2 floated and woke the monitor
    about 3.5 times a second: 353 times in 100 s after Power off.
    - After Power off it went back to sleep each time, unseen, but kept
    drawing current.
    - Switched off for an empty battery, it showed "Battery empty" every
    few seconds and kept draining the battery.
    Now it stays asleep until a real press: 1 wake in a minute's test.
2026-11-04 Battery: tell USB power from the voltage, not only the charge rate
    The battery monitor works out its charge rate from the charge over time,
    so it lags a minute or more behind USB power being plugged in or
    unplugged. Meanwhile the monitor said "in use" on USB power, and after
    starting again on USB power with an empty battery it raised the 20 %
    warning while plugged in.
    - A jump of 60 mV or more between readings now counts as USB power
    plugged in or unplugged, until the rate follows or 5 minutes pass.
    Wi-Fi traffic dips single readings by up to about 45 mV; a reading
    after a dip doesn't count as a rise.
    - Starting again because USB power is back counts as plugged in.
    - Above 4.1 V the b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
    [Power.cpp, Power.h, SensorService.cpp, SensorService.h, UiDraw.cpp, Web.cpp, main.cpp]
2026-11-04 Battery: warn by the voltage too
    The battery monitor's percentage is for a battery at rest. Running the
    monitor, a 400 mAh battery reached 3.5 V, where the monitor switches
    itself off, while it still read about 20 %, so neither warning ever
    came.
    The warnings now also come when the voltage stays at or below 3.6 V
    (low) and 3.55 V (very low) for a minute while discharging, whichever
    comes first. In two discharges of that battery that was 20 to 22 and
    11 to 14 minutes before switching off. A larger battery sags less, so
    its percentage still warns first.
2026-11-04 Battery: show the charge left before it switches itself off
    Running the monitor, a 400 mAh battery reached 3.5 V, where the monitor
    switches itself off, while the battery monitor still read about 20 %,
    so the percentage on the screen, the web page and in Home Assistant
    never got near 0.
    When the monitor switches itself off, it now remembers the battery
    monitor's reading as where "empty" is for that battery, and shows the
    charge from there to full as 0 to 100 %. The warnings at 20 % and 10 %
    count that too. Until it has switched itself off once, e.g. with a new
    battery, it shows the battery monitor's own percentage as before, and
    the voltage warnings still come in time. A reading above 40 %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
2026-11-04 Battery: notice by itself whether one is connected
    Instead of the "A battery is connected" setting, the monitor tells from
    the last 2 minutes of readings. Without a battery the battery monitor
    reads the charger: 4.0 to 4.2 V, jumping about 30 mV from one reading to
    the next. A battery's voltage moves a few mV, and only a battery reads
    below 3.95 V; Wi-Fi traffic makes it jumpy too, but then it's running
    the monitor, well below 4.0 V. The rule held on every recording made so
    far, with and without a battery.
    The answer is kept for the next start, under the old setting's key, so
    a monitor that had the setting ticked starts with a battery and Home
    Assistant doesn't lose and regain the Battery s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
    [MqttService.cpp, Settings.cpp, Settings.h, Ui.cpp, UiDraw.cpp, Web.cpp, main.cpp]
2026-11-04 Battery: start afresh when one is connected to a running monitor
    Without a battery the battery monitor reads the charger, and its charge
    estimate drifts to 95-99 %. Connected to a running monitor, a battery
    kept that estimate: 95 % when it was nearer 50 %.
    When the readings show a battery after none, the battery monitor now
    estimates the charge afresh from the voltage (its QuickStart), and the
    learned "empty" point is forgotten, as it may be a different battery.
    A battery that was there all along, e.g. found again after a restart,
    is left alone.
    [SensorService.cpp, SensorService.h, main.cpp]
2026-11-04 README: the battery in 1.2.0
    - The monitor notices a battery by itself; the setting is gone.
    - The warnings also come by the voltage, and the charge shown counts down
    to where the monitor switches itself off, once it has learned that.
    - USB power always charges the battery to full.
    - The runtime measured with a 400 mAh battery: 1 1/4 hours, about
    250-300 mA.
    - The current while switched off hasn't been measured; the 0.1 mA it
    gave was a guess.
2026-11-09 Screen renderer: follow the battery detection of 1.2.0
    1.2.0 replaced the "A battery is connected" setting with detection, but the
    renderer still set it, so it no longer built. A battery reading now
    connects one, as before, and `battery off` disconnects it; the gallery
    uses that.
    [Simulator.cpp, World.h, main.cpp]
2026-11-09 Display: Silence, to keep the monitor dark at night
    Alerts turn the screen on, so one at night (e.g. humidity reaching 60 %)
    lit up the bedroom. A new setting, in the menu and on the web page: Off;
    Warnings, where only Poor alerts turn the screen on; or All, where none
    does. While it's on:
    - the screen switches off when idle instead of dimming, after the Dim
    after time, or 2 minutes if that's Never;
    - the LED stays off, except while a Poor alert shows with Warnings;
    - a silenced alert waits on the screen until a button wakes it, and only
    then starts its one-minute timeout.
2026-11-09 Home Assistant: switch Silence
    A select under the device's configuration, so automations can silence the
    monitor at bedtime and undo it in the morning. The monitor subscribes to
    <host>/silence/set; the state carries "silence", sent at once whenever it
    changes, from the monitor, the web page or Home Assistant.
2026-11-09 Docs: document the firmware for Doxygen
    Every file in src, lib and test now says what it's for, and every type,
    function, parameter and constant is documented with Doxygen comments.
    The comments explain the design and the reasons behind values, rather
    than how they were found. A few that no longer matched the code were
    corrected.
    `doxygen` in the project folder builds the pages (Doxyfile), into the
    git-ignored .doxygen folder; the README says so.
    [AppLock.h, Device.cpp, Device.h, Json.h, Lgfx.h, MqttService.cpp, MqttService.h, Ota.cpp]
2026-11-09 Docs: document the screen renderer for Doxygen
    The same for tools/screen-renderer: its sources, the stand-ins for the
    Arduino, ESP-IDF and LovyanGFX headers (including where they behave
    differently), and its build files. It has its own Doxyfile.
2026-11-09 Display: fit a version-4 QR code on the screen
    With its quiet zone a version-4 code (54 to 78 bytes) is 148 px at 4 px
    a module, taller than the 135 px screen, so its edges were cut off. It
    now gets 3 px modules; versions 1 to 3 keep 4 px. No text shown today
    needs version 4.
2026-11-09 Screen renderer: accept fixed-ip ON in capitals
    Like the other commands, it now ignores case.
    [main.cpp]
2026-11-09 Screen renderer: micros() wraps at 32 bits everywhere
    unsigned long is 32 bits on Windows but 64 on Linux; it now wraps at 32
    bits on both, as on the ESP32.
2026-11-09 Sensor: read the battery whatever the sensor is doing
    The battery was only read while the sensor was measuring. With the
    sensor missing, failing to start, or busy with a long operation (up to a
    minute to stop, the fan cleaning, the heater), there were no battery
    readings: no low-battery warnings, and no switching off before the
    battery is empty.
    Every wait in the sensor task now keeps reading the battery. Switching
    off and restarting the battery gauge are requests the task serves within
    a fraction of a second instead of queued commands, so they also happen
    mid-operation. Commands sent while the sensor isn't found answer "Sensor
    not found" instead of waiting.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
    [SensorService.cpp, SensorService.h]
2026-11-09 Sensor: say so when it won't start
    If the sensor answered but its measurement wouldn't start, e.g. after a
    maintenance operation, the screen kept showing what it had been doing
    ("Calibrating CO2", "Starting") while it was retried. It now shows the
    sensor as not found until a start works.
    [SensorService.cpp, SensorService.h]
2026-11-09 Sensor: don't pass old readings off as current
    The last readings stayed in place when the sensor stopped measuring:
    during maintenance, while it was missing, or after it stopped answering.
    The screen kept showing them in their level colours, alerts stayed up,
    and Home Assistant kept getting them every 30 s as if new.
    They're now cleared as soon as it stops measuring, so the screen shows
    `--`, the levels are unknown, the history records a gap and Home
    Assistant gets no value. A sensor that answers but hasn't measured for
    10 s is also looked for and started again.
    [SensorService.cpp, SensorService.h]
2026-11-09 Sensor: never drop new settings
    New settings went through the same 4-place queue as the maintenance
    commands. While the sensor task was busy, e.g. waiting up to a minute to
    stop the measurement, the queue could fill: a new altitude or CO2
    self-calibration setting was then saved but not given to the sensor,
    with only a "Sensor busy" message.
    They now wait in a slot of their own, where the latest replaces any
    earlier one, and the sensor task takes them as soon as it can. While the
    sensor isn't found, they're kept for its next start.
    [SensorService.cpp, SensorService.h]
2026-11-09 Sensor: forget the confirmed altitude when it can't be read
    The Device page's confirmed altitude kept an earlier value when reading
    it back failed at a later start; it now shows it as unknown. Also
    documented why the measurement's start time counts from a restart of
    the ESP32 even when the sensor kept measuring.
    [SensorService.cpp, SensorService.h]
2026-11-09 Display: end toasts by clearing them, not by the clock
    A toast showed while its end time was ahead of millis(), compared as a
    signed difference. That holds only within 24.8 days: with no toast yet,
    an empty grey band covered the title bar from then on, and an old toast
    came back 24.8 days after it had gone. A toast is now cleared once its
    time is up and shown only while it has text.
2026-11-09 Alerts: a value briefly unknown hasn't improved
    An alert's acknowledgement is lowered when the value improves, so it
    alerts again if it gets worse. Unknown counted as an improvement, and PM
    values are unknown for 30 s after every measurement restart (a settings
    change, fan cleaning, calibration...): a dismissed PM alert then popped
    up again and turned the screen on. Unknown now leaves it as it is.
2026-11-09 Silence: a very low battery still turns the screen on with Warnings
    With Silence on Warnings, the battery's warnings counted as warnings, so
    the monitor could switch itself off at night for an empty battery with
    no visible warning before. A very low battery now counts as an alarm,
    which Warnings lets through; a low one still waits. All still silences
    everything.
2026-11-09 Clocks: count running and measuring time past 49.7 days
    millis() wraps after 49.7 days, which a monitor on USB power easily
    runs. The uptime on the Device page and in /api/state started again
    from zero, and so did "Measuring for". In the sensor task, each wrap
    also blanked the PM values for 30 s, and could hold a stop or a CO2
    calibration back by up to 3 minutes.
    They now come from ESP-IDF's 64-bit timer (Uptime.h). Short timeouts,
    measured as differences of millis(), were already safe. The screen
    renderer gets a stand-in for the timer.
    [Platform.cpp, SensorService.cpp, SensorService.h, UiDraw.cpp, Uptime.h, Web.cpp, esp_timer.h]
2026-11-09 Display: an idle screen stays dark past 49.7 days
    The time since the last button press is a difference of millis(), which
    wraps after 49.7 days. Without a press for that long, it looked recent
    again, and a screen switched off lit up for the idle time. While idle,
    it now stops growing.
2026-11-09 Display: shorten long text by whole characters
    Text too wide for its space, e.g. a long Wi-Fi name, was shortened a
    byte at a time, which could cut a multi-byte UTF-8 character in half.
    It's now shortened a character at a time.
    [Text.cpp]
2026-11-09 Web: accept only JSON objects of a sane depth
    The JSON parser recurses for each level of nesting, up to 1000, and the
    web server's task has an 8 KB stack: a body of a few hundred brackets
    would crash the monitor. Bodies nested deeper than 8 levels are now
    refused before parsing (the API needs 2). Bodies that are JSON but not
    an object, e.g. [] or 5, were taken as an empty change; they're now
    refused too.
    [Web.cpp]
2026-11-09 Web: give up on stalling clients sooner
    The server handles one request at a time, so a client on the network
    that sent its request slowly held up everyone else: 10 s per stall, and
    up to a minute for a request body. It now waits 5 s for a client's next
    bytes, and a small JSON body that stalls fails at once. A firmware
    upload still allows a few stalls.
    [Web.cpp]
2026-11-09 Web page: save only the settings changed in the form
    Save sent every setting as the form had loaded it, so it undid changes
    made meanwhile elsewhere: e.g. Silence switched from Home Assistant at
    night went back to Off when the name was edited in a page left open
    since the morning. It now sends only the settings changed in the form.
2026-11-09 Web page: time out stalled requests; show missing battery values
    The page's requests had no time limit: on a stalled connection, polling
    stopped without showing the offline banner, and an upload could wait
    forever. Requests now give up after 15 s (2 minutes for the CSV
    download), and an upload after 5 minutes.
    A battery reading with no voltage stopped the Device section from
    drawing, and one with no percentage showed "null %"; both show "?".
2026-11-09 Web passwords: a wait after wrong passwords ends for good
    The wait was timed with millis(), which wraps after 49.7 days: if the
    last thing before that was a wait after wrong passwords, it came back
    for up to 15 minutes at the wrap. LoginGuard now takes a time that
    doesn't wrap, the monitor's 64-bit uptime.
    [Web.cpp]
2026-11-09 Wi-Fi: save the networks without erasing them first
    Saving erased every saved network and then wrote them again, after each
    change (adding, forgetting, a fixed address). A power cut or crash in
    between lost them all, and with them the way to reach the monitor. They
    are now written over the old ones, the count after them, and what's no
    longer needed is removed last: a power cut leaves old networks, new ones
    or a mix, but never none. A failed save is logged.
    [WifiStore.cpp]
2026-11-09 MQTT: start whenever it's wanted, also after 24.8 days
    When the client could start was a millis() time, starting at 0 and
    compared as a signed difference. Past 24.8 days of uptime that read as
    not yet: if Home Assistant was first turned on, or Wi-Fi first joined,
    that late, the client wouldn't start until millis() wrapped at 49.7
    days. It now starts at once unless a start was tried in the last minute.
2026-11-09 Home Assistant: ignore retained Silence commands
    Home Assistant's select doesn't retain its commands, but an automation
    publishing to the topic with retain set would leave one on the broker,
    applied again at every reconnect over whatever was set since. Retained
    commands are now ignored.
    [MqttService.cpp]
2026-11-09 MQTT: show "waiting" without Wi-Fi, and don't stall stopping
    After Wi-Fi went, the client only noticed the broker was gone a
    keepalive later, up to 90 s, and the screen and web page showed Home
    Assistant as connected meanwhile; it now shows waiting as soon as Wi-Fi
    is down. Stopping the client (new settings, switching off) no longer
    tries to say "offline" without Wi-Fi, which held up the monitor for the
    network timeout.
    [MqttService.cpp]
2026-11-09 MQTT: a client id unique to each monitor
    The client id was the host name, which has only the last 4 hex digits
    of the MAC address. Two monitors sharing them (1 in 65536) would keep
    pushing each other off the broker, which drops a client when another
    connects with the same id. The id now has the whole MAC address. The
    host name, the topics and the ids Home Assistant knows the monitor by
    stay as they were, so existing setups keep working.
    [MqttService.cpp, MqttService.h]
2026-11-09 Wi-Fi: don't offer networks the monitor can't join
    The Arduino core joins only open networks and WPA2 or newer, but the
    list of networks on the setup and web pages also showed WEP, the first
    WPA and enterprise networks: chosen, they failed with a misleading
    "Network not found". They're now left out of the list.
    [WifiService.cpp]
2026-11-09 Battery: a load ending doesn't put off switching off
    A jump up in voltage reads as USB power plugged in, and makes the state
    Charging until the charge rate follows, for up to 5 minutes. But a heavy
    load ending lifts the voltage too: near empty, that kept the monitor
    running on a flat battery for up to 5 more minutes. Switching off now
    also follows the rate itself; real USB power lifts the voltage above the
    limit anyway. With a test.
2026-11-09 Battery: keep the learned empty point after a moment's doubt
    When the readings showed a battery after showing none, the monitor
    forgot where "empty" was, since it might be another battery. A full
    battery on USB that briefly looked like the charger alone would have
    lost it too. It's now forgotten only if there was no battery for at
    least 2 more minutes; the gauge's estimate still starts afresh either
    way. With a test.
2026-11-09 Screen renderer: tidy the battery commands' help
    The help ran `battery ... | none` into its description; `battery none`
    now has a line of its own, like `battery off`.
2026-11-09 Docs: correct the README where the review found it wrong
    - Wrong passwords: someone who keeps sending them can keep you out; a
    restart clears the count. It said they couldn't for over 15 minutes.
    - What anyone on the network sees: also the saved network names, fixed
    addresses and the broker's address and user name. Saved passwords are
    unencrypted in flash.
    - Silence lets a very low battery through with Warnings; alerts close
    with a short press; D1 or D2 start the monitor after an empty battery
    only once USB power shows, up to a minute after plugging in.
    - Power off can't be cancelled, and a connected battery slowly runs
    down while off; Wi-Fi needs WPA2 or WPA3; anyone who can pub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
2026-11-09 Docs: call the MAX17048 the battery gauge throughout
    Comments called it the "battery monitor", next to "the monitor" for the
    device itself, often in the same sentence. They now say "battery gauge",
    as the README does. BatteryWatch's docs also say that its readings are
    expected about every 5 s, which its time-based constants assume.
2026-11-09 Docs: fix the comments the review found wrong or unclear
    - Rewritten as reasons rather than test notes: the screen's offset, the
    shortest measurement run, DHCP option 114, AUTH_EXPIRE, the MQTT
    retry delay and send buffer.
    - Corrected: when a saved network is looked for during setup, and what
    becomes of the joined one; LED amber, not orange; an alert closes with
    a short press; the history ranges' sizes; the API's 401, 403 and 429
    answers and null gaps.
    - Added: what rollback relies on and what a restart on probation does;
    how long an update's outcome lasts; why switching off for the battery
    leaves the gauge awake; that Power off can't be cancelled and nothing
    watches the batt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
    [Device.h, Lgfx.h, MqttService.cpp, Ota.h, Power.h, SensorService.cpp, SensorService.h, StatusLed.h]
2026-11-09 Add a 3D-printable enclosure
    Two STEP files (body and lid) in enclosure/, a photo of the built monitor
    (cropped, downscaled, without metadata) in docs/, and a README section on
    fitting the parts: nylon screws and nuts for the Feather (M2.5 at the USB
    end, M2 at the other, as Adafruit's board file has 2.5 mm and 2.2 mm holes),
    the sensor clipped in, the lid held by friction, foam around the sensor and
    a pad under the enclosure. STEP files are kept byte for byte (binary in
    .gitattributes).
    [lid.step, main_enclosure.step]
